Gabaly92/Senior-Design-Project-ILATS/System High level Diagram.png

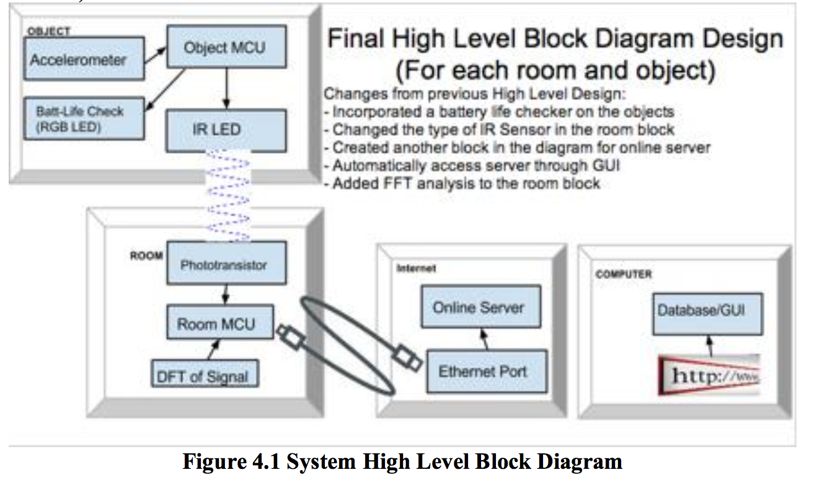
System High level Diagram.png
