Gabaly92/Senior-Design-Project-ILATS/lower_level_design.jpg

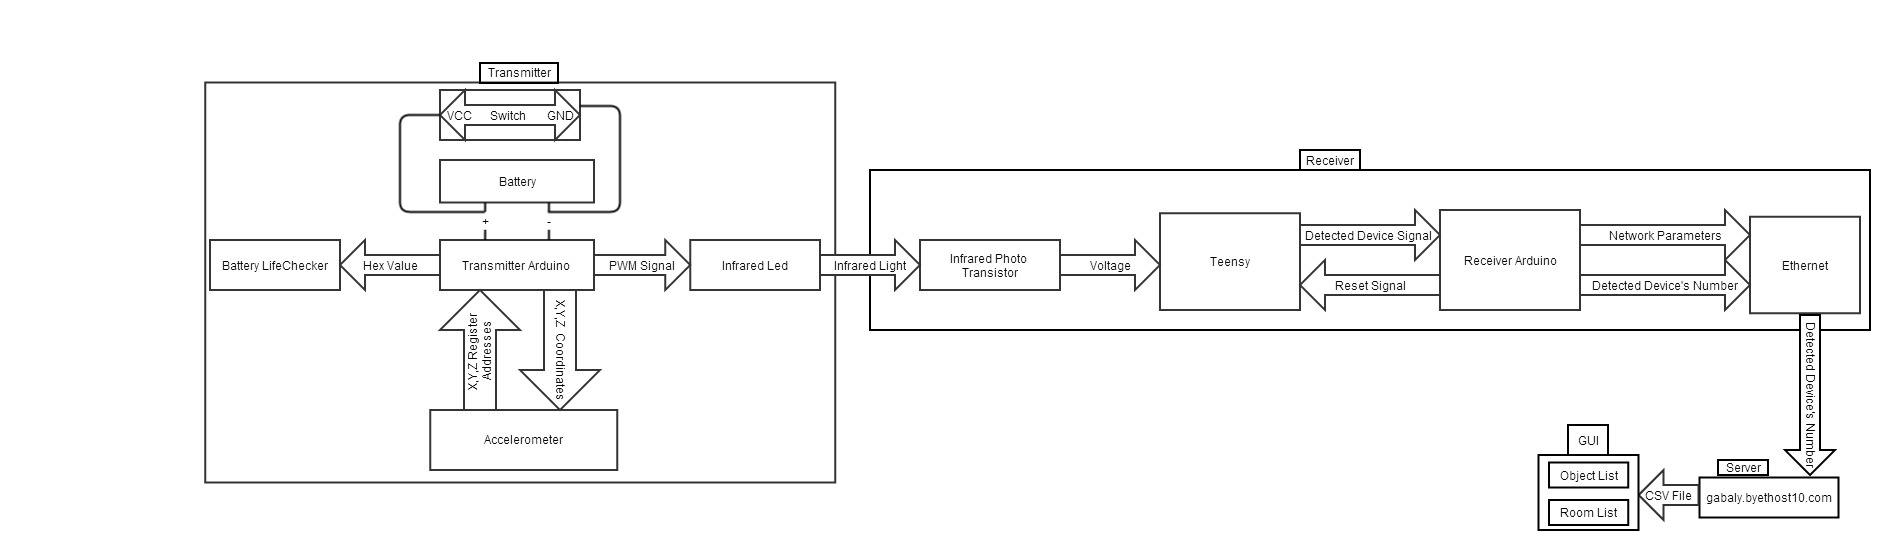
lower_level_design.jpg
